ericsandine/fire-hd-10-mount/3mf/fire_hd10_mount.3mf

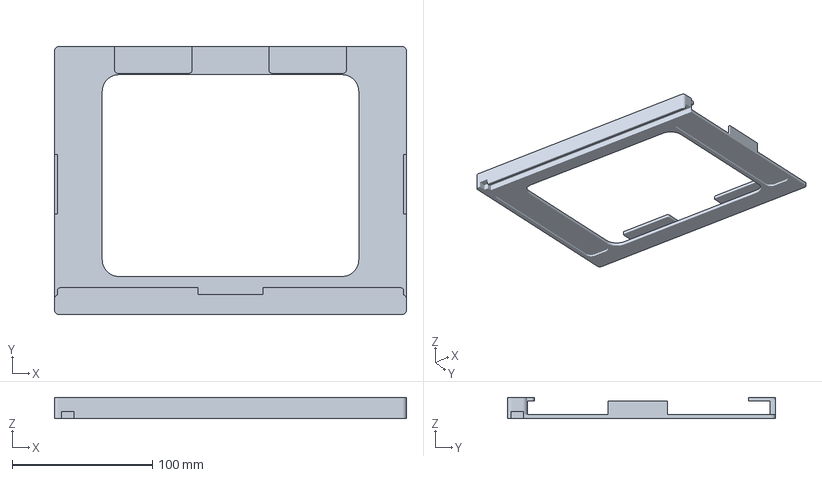
[picture p6: CAD file, 2026-10-27]
3mf/fire_hd10_mount.3mf
250.8 x 190.8 x 15.0 mm
