ericsandine/fire-hd-10-mount/(list of files, cad)

Other CAD files:
stl/fire_hd10_mount.stl
