ericsandine/fire-hd-10-mount/(commit log)

2026-10-25 Fire HD 10 (2023) landscape wall mount: parametric model, STL, 3MF
    Flat-backed landscape cradle for a Fire HD 10 (13th gen) Home Assistant panel,
    sized for Command 20 lb XL picture-hanging strips. Both short edges open for
    USB-C/power/volume access; lift-and-drop retention with top clips, weight-bearing
    bottom shelf, and nested corner brackets for sideways stops.
    Claude-Session: https://claude.ai/code/session_01StdfYpc3TEws84bizmQcm3
    [fire_hd10_mount.3mf, fire_hd10_mount.scad, fire_hd10_mount.stl]
2026-10-25 Fix 3MF: emit clean core-spec 3MF Bambu Studio accepts
    OpenSCAD's native 3MF export embeds base-materials + newer schema namespaces
    that Bambu Studio flags as 'invalid config, loading geometry only'. Replace it
    with a minimal core-spec 3MF (verified watertight/manifold, Genus 1, identical
    121.093 cm^3 volume) generated from the STL via tools/stl_to_3mf.py.
    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
    [fire_hd10_mount.3mf]
2026-10-25 Add cable routing, recessed strip pads, and edge styling
    - Cable channel across the base (USB edge -> down -> under tablet -> out
    bottom-left) with 3 retention bridges; cut only into the front block so the
    back stays flat. Fits a ~4-5mm USB-C cable.
    - Two shallow 1.5mm Command-strip recesses on the back so the mount sits
    closer to the wall.
    - Polish: larger corner radii, beveled front edge, chamfered window, rounded
    clips and lip.
    - Regenerated STL + clean 3MF (manifold, watertight, ~72 g PLA). Updated docs.
    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
    [fire_hd10_mount.3mf, fire_hd10_mount.scad, fire_hd10_mount.stl]
2026-10-25 Route cable on the back instead of the front
    The channel now cuts into the BACK of the base (wall side) rather than the
    front, so nothing is visible across the front. Cable enters from the open
    right edge, runs hidden behind the tablet, and exits bottom-left against the
    wall. Retention tabs hold it before mounting; the wall holds it after. Only
    the thick base is cut, so strip surfaces and the rest of the back stay flat.
    Regenerated STL + clean 3MF (manifold, watertight, ~74 g). Updated docs.
    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
    [fire_hd10_mount.3mf, fire_hd10_mount.scad, fire_hd10_mount.stl]
2026-10-25 v2: usable open cable groove, flush-seating bottom, squared edges
    Rework after the first test print:
    - Cable channel -> genuinely OPEN lay-in groove on the back (no roof to
    bridge, no retention tabs). In from the right edge, across, out bottom-left;
    the wall caps it when hung.
    - Bottom seats flush: dropped the square corner brackets that fought the
    tablet's rounded corners. Sideways slide is now stopped by two slim side
    rails that catch the straight side edges, starting above the corner radius.
    Plate widened to 250.8 mm (still inside a 256 mm bed).
    - Flush/squared look: removed bevels and window/clip chamfers, minimal
    corner rounding.
    Manifold (NoError), ~74 g PLA, 250.8 x 197.8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
    [fire_hd10_mount.3mf, fire_hd10_mount.scad, fire_hd10_mount.stl]
2026-10-25 Cable channel: self-supporting 45-degree peaked roof
    The open groove was open on the back face, but printed back-down that opening
    faces the bed and the flat roof over it was an 8 mm bridge (would need supports
    / could sag closed, as in v1). Replace the flat roof with a 45-degree peak so
    the channel corbels in and prints with no supports and no sag, while staying
    fully open on the back for lay-in. The V also lightly cradles the cable.
    Added images/section.png (channel cross-section). Manifold (NoError).
    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
    [fire_hd10_mount.3mf, fire_hd10_mount.scad, fire_hd10_mount.stl]
2026-10-25 Cable channel: simplify to a plain open channel (drop the peak)
    The 45-degree peak was over-engineering and read as a weird triangle. Replace
    with a plain rectangular open channel, 9 x 5 mm (oversized/forgiving). Verified
    in print orientation (back-down): the only down-facing surfaces are the 3 front
    lip undersides (need support), the strip-recess floors (18 mm shallow self-
    bridge), and the channel roof (short ~9 mm bridge). Nothing needs the channel
    supported; it is not an enclosed tunnel. Docs corrected to match.
    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
    [fire_hd10_mount.3mf, fire_hd10_mount.scad, fire_hd10_mount.stl]
2026-10-25 Docs: clearer channel cross-section (open wall side, solid front cover)
    No model change — the channel already matches intent: open toward the wall,
    solid cover on the front (under the tablet). Replace section.png with a labeled
    schematic showing the cable open to the wall side and the solid front cover,
    and update the caption.
    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
2026-10-25 Fix sealed cable channel and floating bottom lip; correct support advice
    Two real bugs in the STL, both reported from the slicer:
    - Cable channel was sealed on the wall side. It was only subtracted from
    base(), but the 3 mm back plate also covers that region, so the union
    closed the back of the channel into a tunnel (the slicer's dashed line).
    The channel is now cut from the whole assembled part in mount().
    This was also the real cause of the v1 "can't run a wire through it".
    - The bottom lip (both halves around the finger notch) was 2 separate
    floating shells: it touched the base only along an edge once the corner
    brackets were removed. The base now runs the full depth and the l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
    [fire_hd10_mount.3mf, fire_hd10_mount.scad, fire_hd10_mount.stl]
2026-10-27 v3: clear the USB-C port, cut the top gap, widen strip pads
    From measurements on the second print:
    - Side rails moved to 58-98 mm above the tablet's bottom edge, between
    the measured USB-C plug (40-52 mm) and the buttons (~106 mm). The v2
    right rail covered the port. Positions are parameters (usb_y0/usb_y1/
    btn_y0) and the rails place themselves between them.
    - Space above the tablet 19 -> 12 mm: bottom lip 8 -> 5 mm, so lift
    11 -> 7 mm; head 2 -> 1; top bar 6 -> 4. Assert lift >= lip + 2.
    - Strip recesses 18 -> 25 mm wide for the 22.4 mm XL strips; side frame
    30 -> 34 mm so the recess keeps 4.5 mm walls.
    - New images/usb.png fit view; README updated (2 strip pairs, port
    measurem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
    [fire_hd10_mount.3mf, fire_hd10_mount.scad, fire_hd10_mount.stl]
